gefox00/faiz-trussed-cabinet/images/cabinet.png

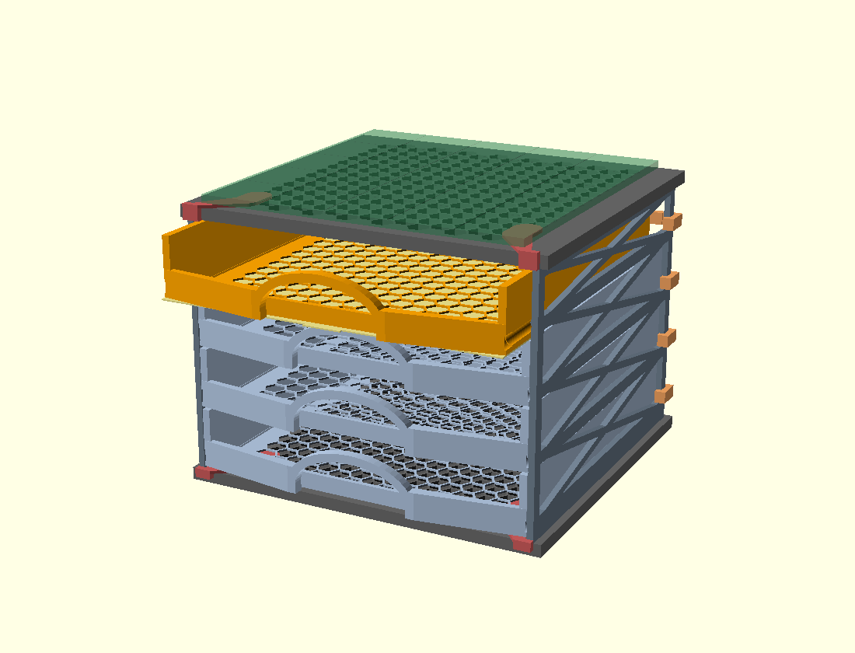
images/cabinet.png
