gefox00/faiz-trussed-cabinet/stl/reinforcements/bottom_stop_left.stl

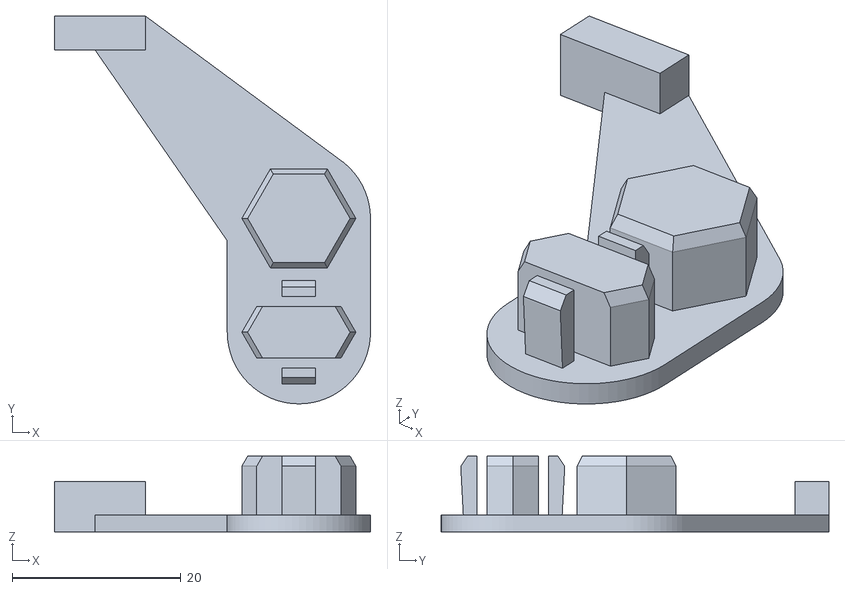
[picture p3: CAD file, 2026-11-03]
stl/reinforcements/bottom_stop_left.stl
37.5 x 46.0 x 9.00
