gefox00/faiz-trussed-cabinet/stl/transport/03_frame.stl

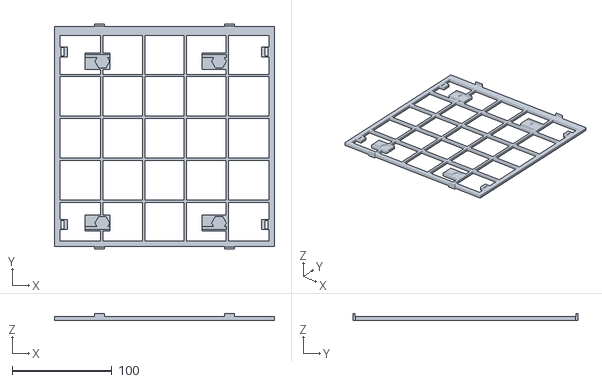
[picture p4: CAD file, 2026-11-03]
stl/transport/03_frame.stl
220.6 x 225.4 x 6.90
