gefox00/faiz-trussed-cabinet/stl/reinforcements/tie_bar.stl

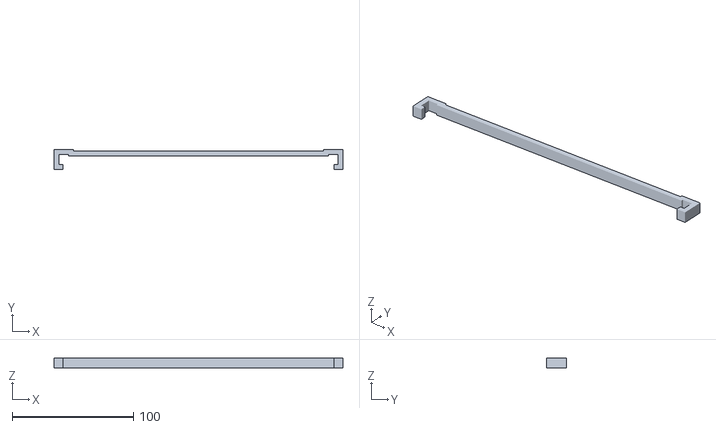
[picture p5: CAD file, 2026-11-03]
stl/reinforcements/tie_bar.stl
238.1 x 16.6 x 8.00
