gefox00/faiz-trussed-cabinet/stl/transport/02_front_gate.stl

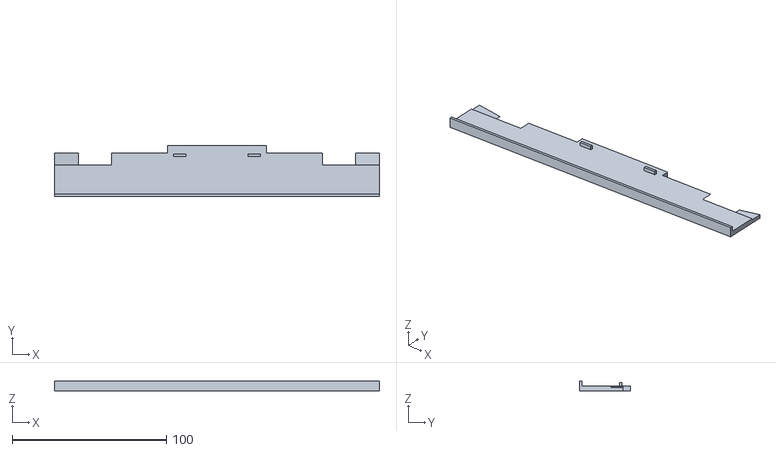
[picture p6: CAD file, 2026-11-03]
stl/transport/02_front_gate.stl
210.4 x 33.2 x 6.30
