gefox00/faiz-trussed-cabinet/stl/reinforcements/top_stop_right.stl

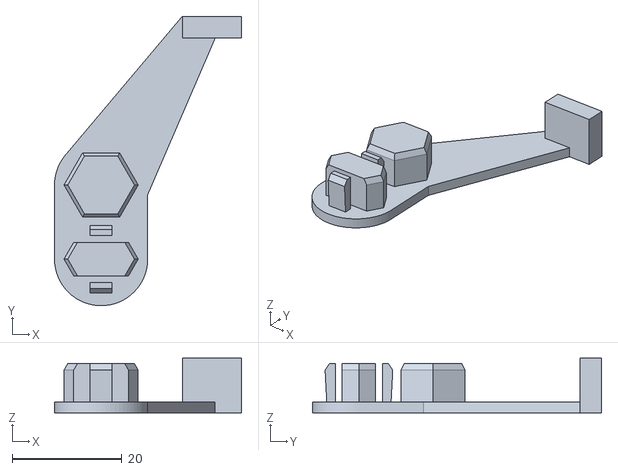
[picture p7: CAD file, 2026-11-03]
stl/reinforcements/top_stop_right.stl
34.1 x 52.8 x 10.0
