gefox00/faiz-trussed-cabinet/stl/transport/04_clip_print_4.stl

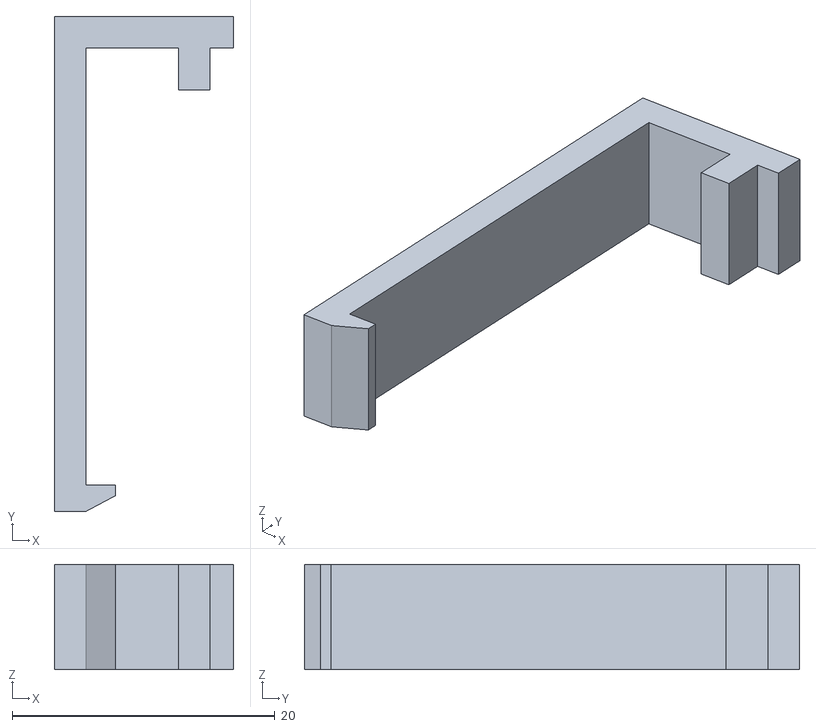
[picture p8: CAD file, 2026-11-03]
stl/transport/04_clip_print_4.stl
13.6 x 37.6 x 8.00
