gefox00/faiz-trussed-cabinet/stl/reinforcements/top_stop_left.stl

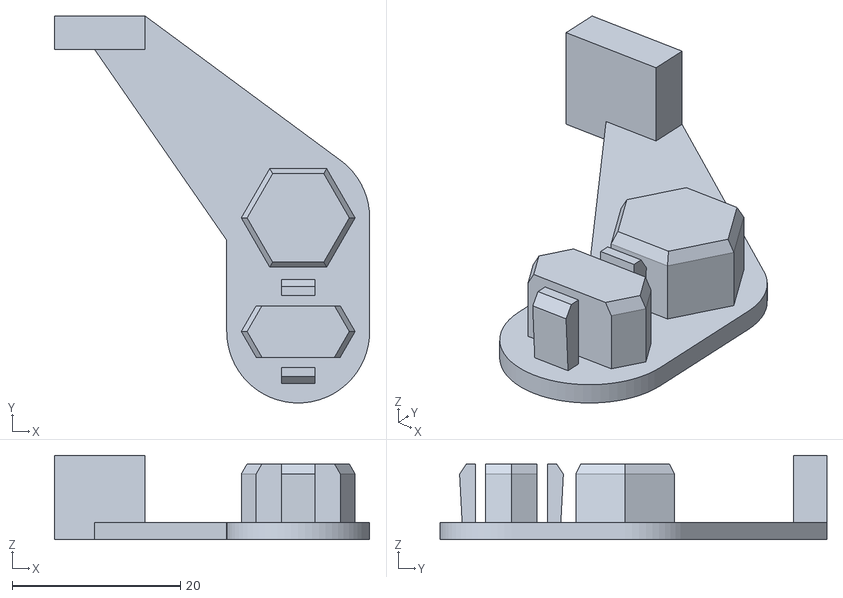
[picture p9: CAD file, 2026-11-03]
stl/reinforcements/top_stop_left.stl
37.5 x 46.0 x 10.0
