gefox00/faiz-trussed-cabinet/stl/transport/05_snap_fit_test.stl

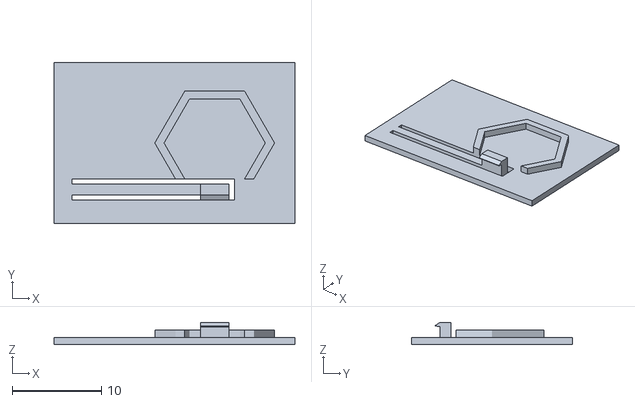
[picture p10: CAD file, 2026-11-03]
stl/transport/05_snap_fit_test.stl
27.0 x 18.0 x 2.50
