gefox00/faiz-trussed-cabinet/stl/reinforcements/bottom_stop_right.stl

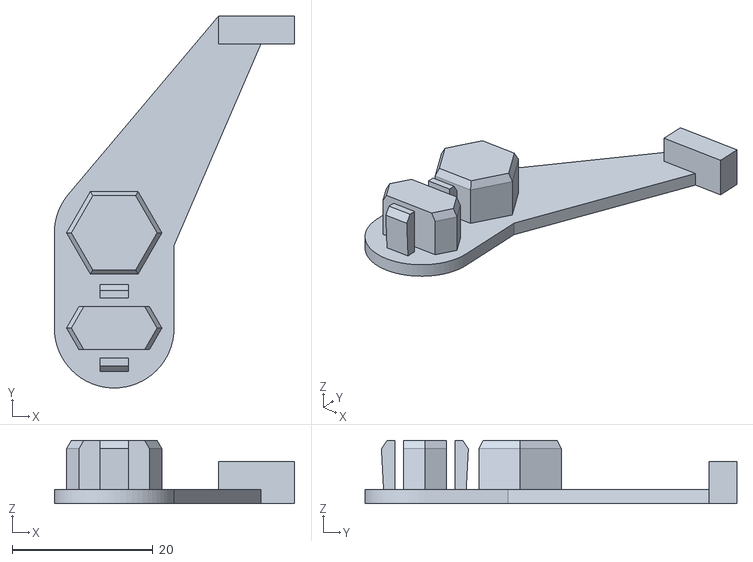
[picture p11: CAD file, 2026-11-03]
stl/reinforcements/bottom_stop_right.stl
34.1 x 52.8 x 9.00
