gefox00/faiz-trussed-cabinet/stl/transport/01_lid.stl

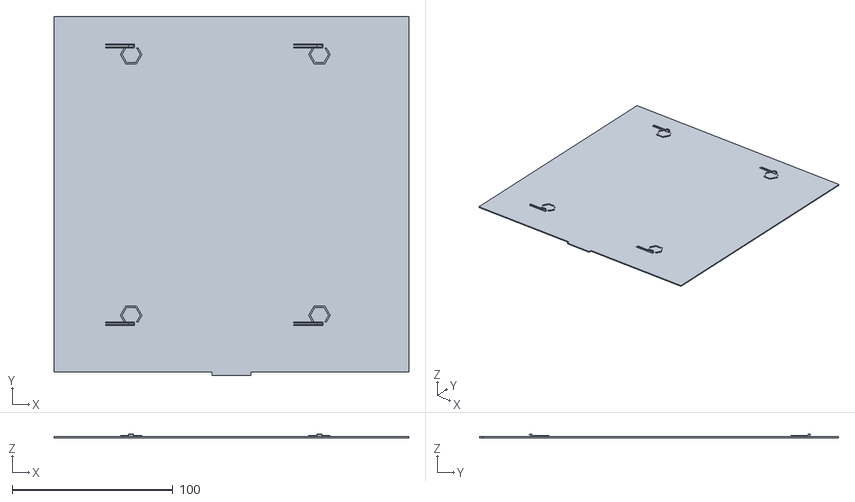
[picture p12: CAD file, 2026-11-03]
stl/transport/01_lid.stl
220.6 x 223.3 x 2.50
