gefox00/faiz-trussed-cabinet/(commit log)

2026-11-03 Add parametric FAIZ cabinet source
    [faiz_cabinet.scad]
2026-11-03 Add printable transport lid kit
    [01_lid.stl, 02_front_gate.stl, 03_frame.stl, 04_clip_print_4.stl, 05_snap_fit_test.stl]
2026-11-03 Add tie bars and top/bottom rail stops
    [bottom_stop_left.stl, bottom_stop_right.stl, tie_bar.stl, top_stop_left.stl, top_stop_right.stl]
2026-11-03 Document parts, materials and assembly
